JVenberg/curved-cat-door-latch/out/preview.png

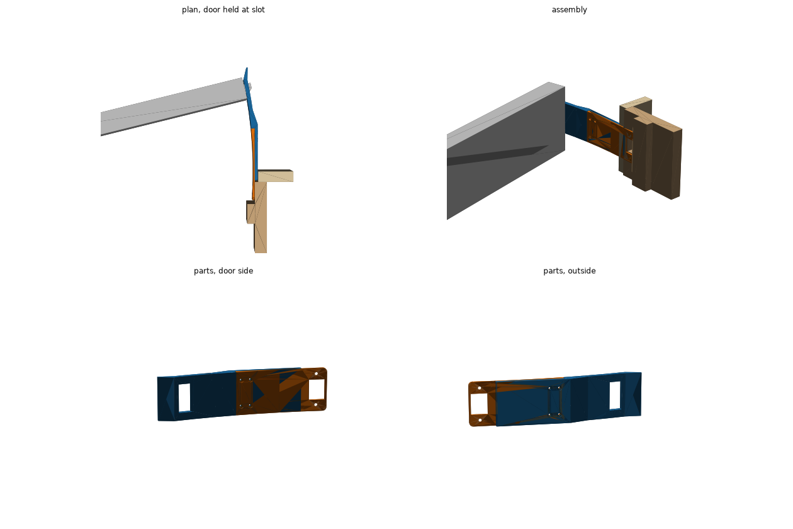
out/preview.png
