JVenberg/curved-cat-door-latch/cat-door-latch.3mf

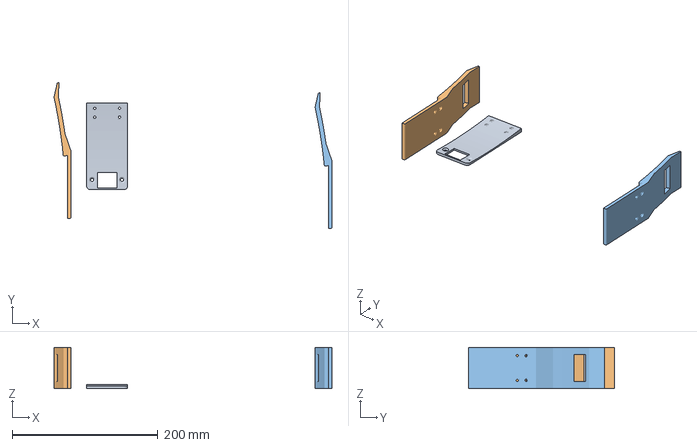
[picture p7: CAD file, 2026-10-17]
cat-door-latch.3mf
381.6 x 200.2 x 56.4 mm
face_plate.stl
latch_arm.stl x 2
