JVenberg/curved-cat-door-latch/original/cat-door-latch-plate.stl

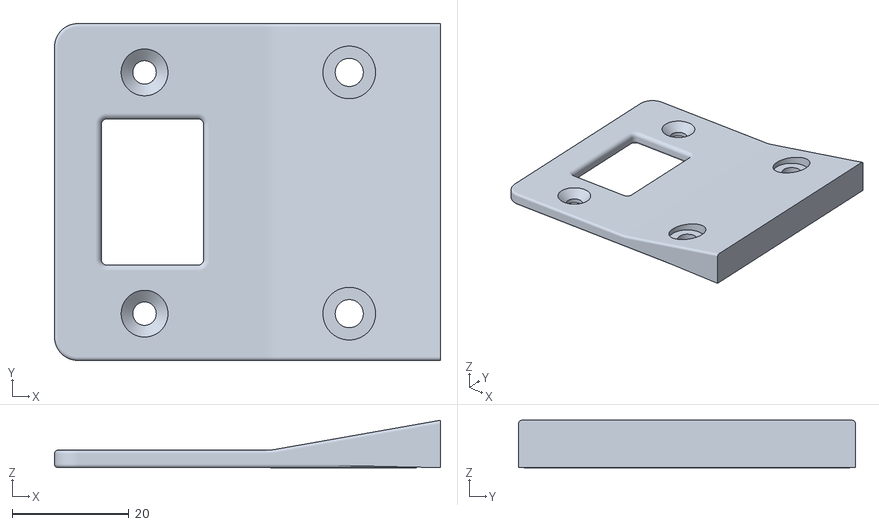
[picture p8: CAD file, 2026-10-17]
original/cat-door-latch-plate.stl
66.0 x 57.6 x 8.13
