JVenberg/curved-cat-door-latch/out/ref_door_at_slot.step

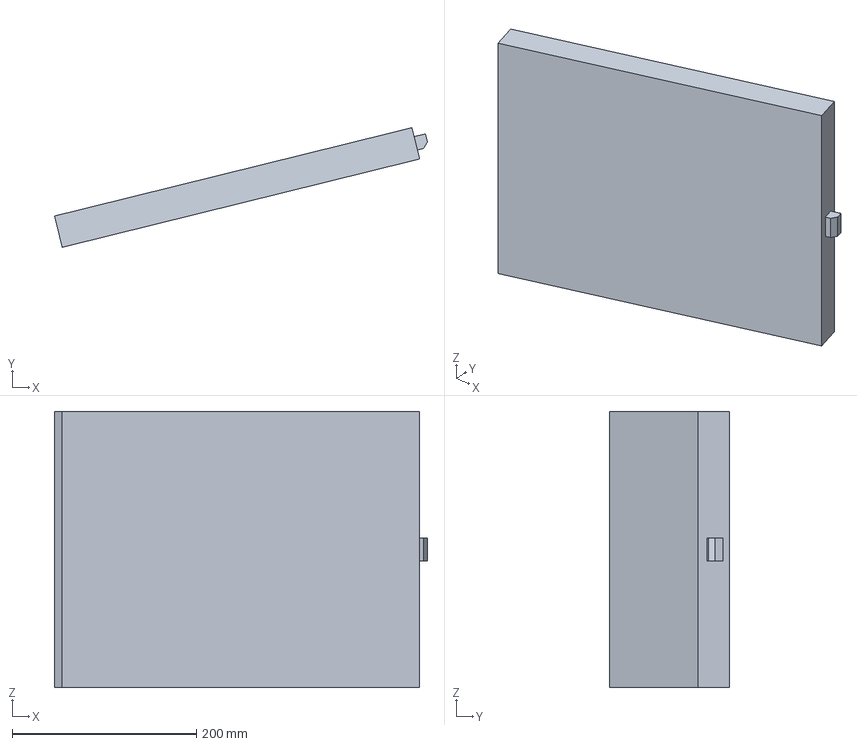
[picture p9: CAD file, 2026-10-17]
out/ref_door_at_slot.step
405.2 x 129.9 x 300.0 mm
