JVenberg/curved-cat-door-latch/original/cat-door-latch-extension.stl

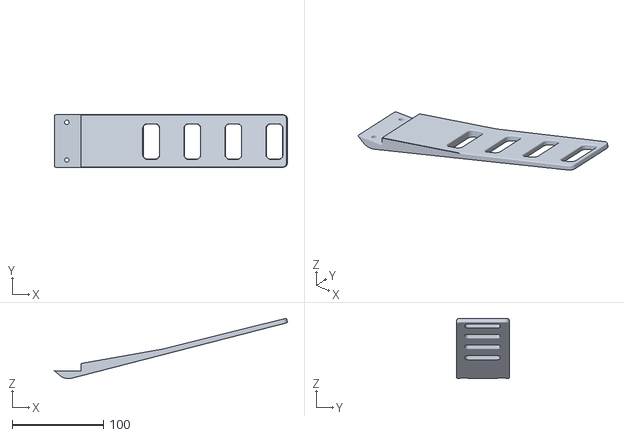
[picture p10: CAD file, 2026-10-17]
original/cat-door-latch-extension.stl
255.1 x 57.6 x 66.0
