JVenberg/curved-cat-door-latch/out/latch_arm.step

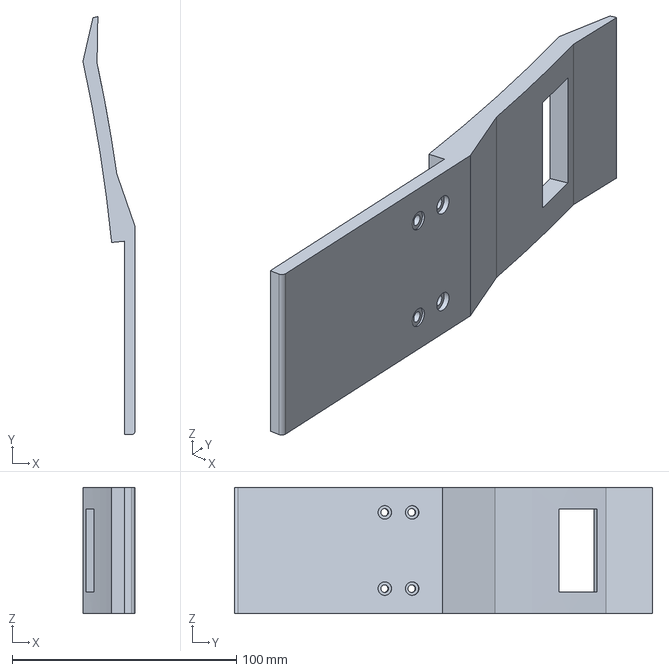
[picture p11: CAD file, 2026-10-17]
out/latch_arm.step
23.3 x 186.4 x 56.4 mm
