JVenberg/curved-cat-door-latch/out/face_plate.step

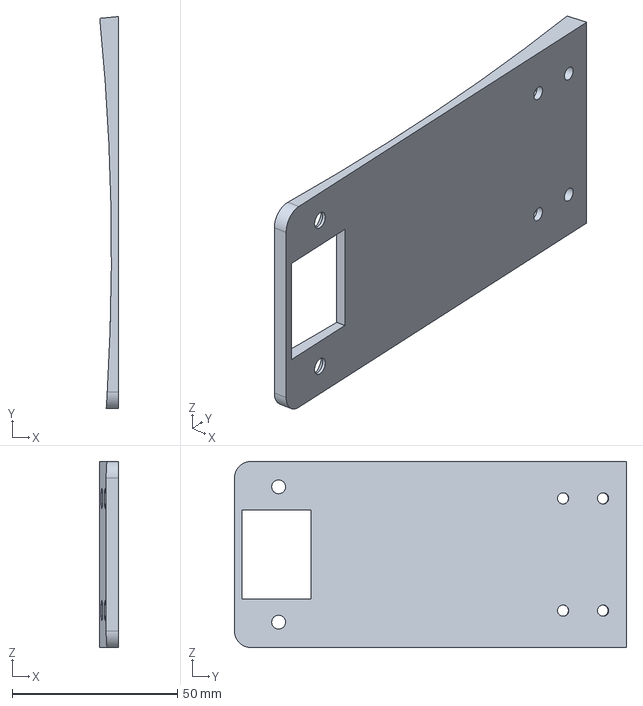
[picture p12: CAD file, 2026-10-17]
out/face_plate.step
5.62 x 118.8 x 56.4 mm
