JVenberg/curved-cat-door-latch/out/ref_lock_jamb.step

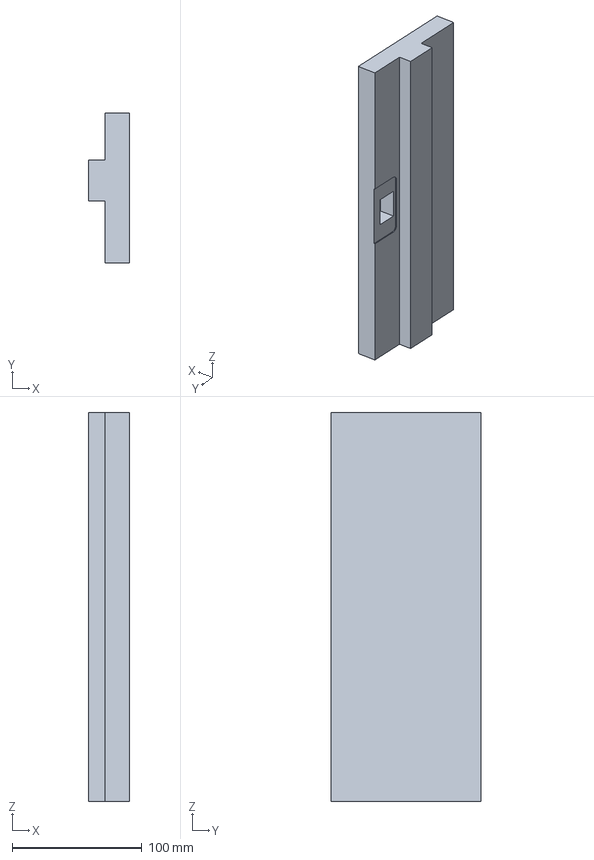
[picture p13: CAD file, 2026-10-17]
out/ref_lock_jamb.step
31.8 x 115.9 x 300.0 mm
