JVenberg/curved-cat-door-latch/out/ref_casing.step

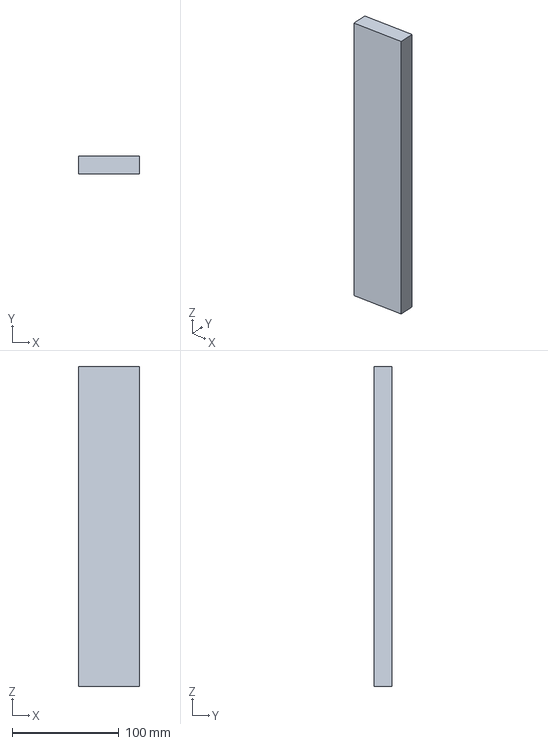
[picture p14: CAD file, 2026-10-17]
out/ref_casing.step
57.1 x 17.0 x 300.0 mm
