JVenberg/curved-cat-door-latch/(list of files, cad)

Other CAD files:
out/face_plate.stl
out/latch_arm.stl
