JVenberg/curved-cat-door-latch/original/763947-cat-door-latch-rev-2-af026876-dc0f-473a-8c19-b73474e39ffc.pdf

## Cat Door Latch rev

2

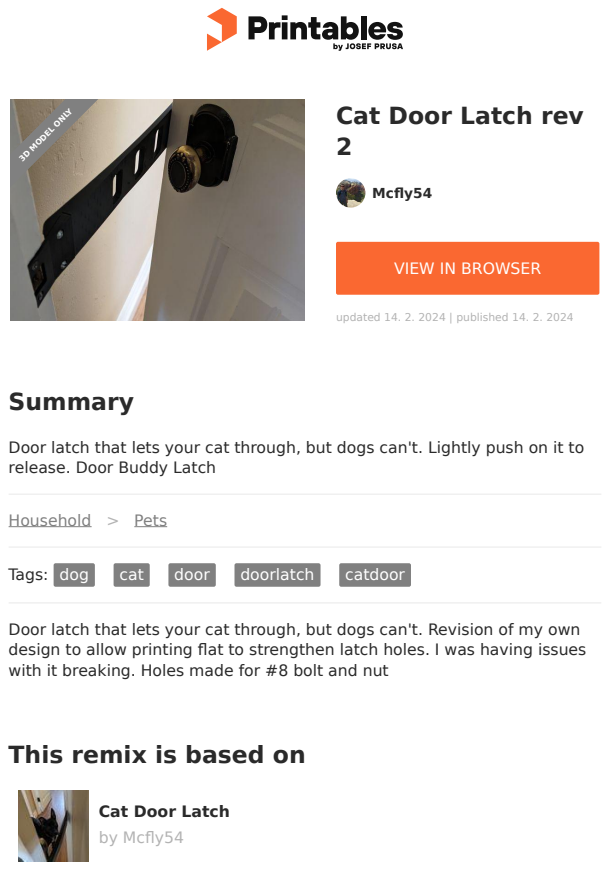
[picture p15: page 1]
Summary; Household; Pets; Tags: dog; cat; door; doorlatch; catdoor; by Mcfly54; Mcfly54; updated 14. 2. 2024 | published 14. 2. 2024; 3D MODEL ONLY

VIEW IN BROWSER (https://printables.com/model/763947-cat-door-latch-rev-2)

Door latch that lets your cat through, but dogs can't. Lightly push on it to
release. Door Buddy Latch

Door latch that lets your cat through, but dogs can't. Revision of my own
design to allow printing flat to strengthen latch holes. I was having issues
with it breaking. Holes made for #8 bolt and nut

This remix is based on

Cat Door Latch (https://printables.com/model/742575-cat-door-latch)

# Model files

## License

This work is licensed under a
Creative Commons (International License)

Public Domain (https://creativecommons.org/share-your-work/public-domain/cc0/)

✔ | Sharing without ATTRIBUTION
✔ | Remix Culture allowed
✔ | Commercial Use
✔ | Free Cultural Works
✔ | Meets Open Definition

cat-door-latch-extension.stl

cat-door-latch-plate.stl
