JVenberg/curved-cat-door-latch/out/hinge_measure.png

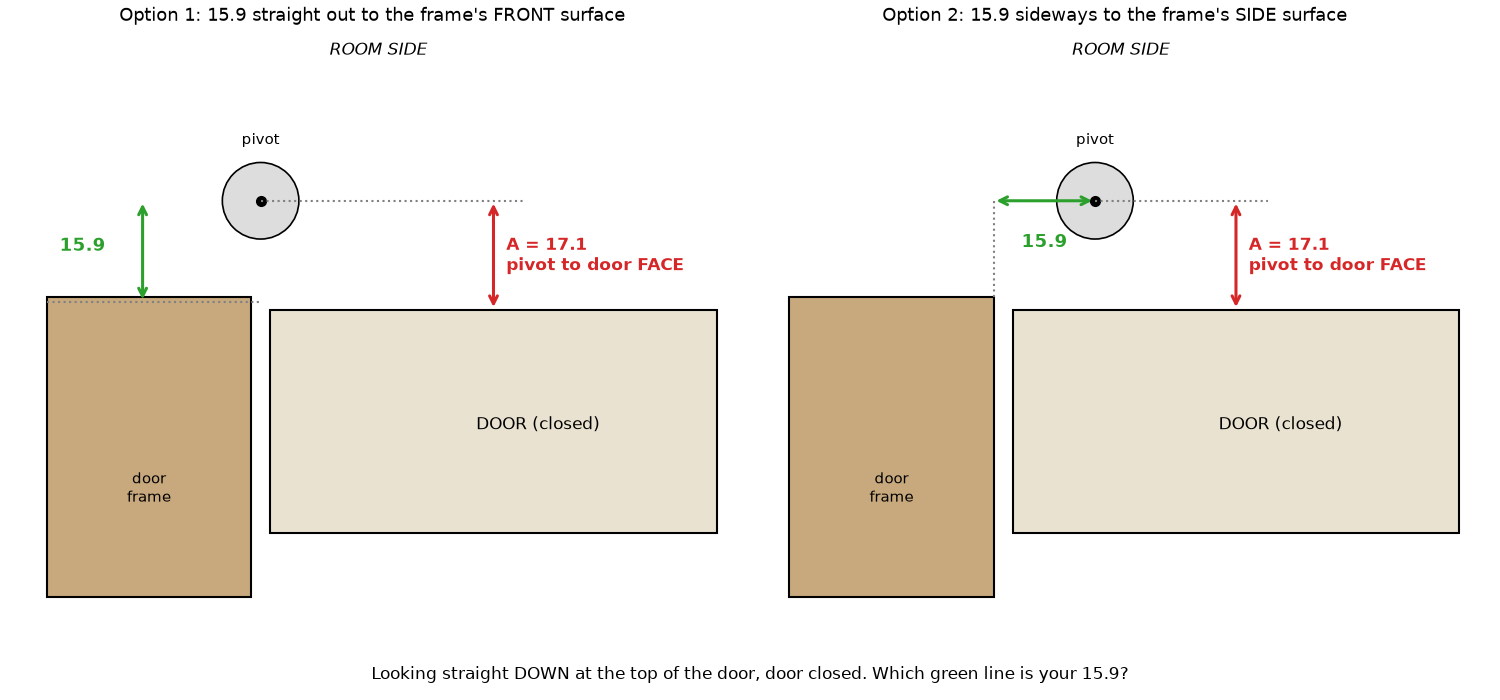
out/hinge_measure.png
