JVenberg/curved-cat-door-latch/(commit log)

2026-10-17 Curved cat door latch: parametric face plate and latch arm
    Remix of Printables "Cat Door Latch rev 2" as a build123d model with a
    face plate and an arc-following latch arm, clearance checks, preview
    script, and notes on measurements and install lessons.
    Claude-Session: https://claude.ai/code/session_017oSnG4KLpSGDZDYQZdmLJC
    [cat-door-latch-extension.stl, cat-door-latch-plate.stl, cat-door-latch.3mf, face_plate.step, face_plate.stl, latch_arm.step, latch_arm.stl, ref_casing.step]
2026-10-17 Add README, renders and render script
    Rewrite the README with photos-style renders, hardware, install and
    print guidance; add a PyVista render script for the images and keep
    NOTES.md wording neutral for a public repo.
    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
2026-10-17 Add CC0 license
    Matches the original Printables design's CC0 dedication.
    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
